kacprow21324/STM32F3Discovery-Autonomiczny-Pojazd/README.md

# 🚗 Autonomiczny Pojazd z STM32

Projekt semestralny z przedmiotu **Systemy Wbudowane i Mikrokontrolery**  
Autor: Kacper Adam Woszczyło  
Numer indeksu: 21324  
Data rozpoczęcia: 28.04.2025   
Repozytorium zawiera kod, dokumentację oraz materiały projektowe.

---

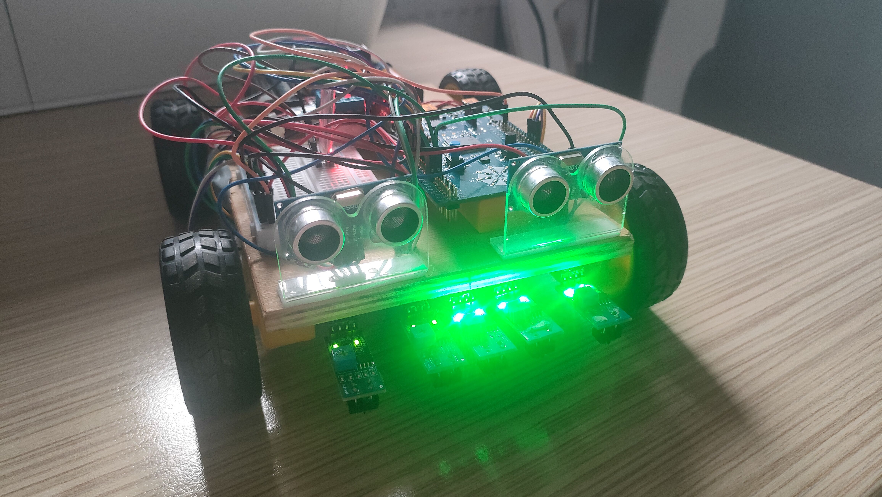
[picture p1: Media/Zdjęcia/M3_3.jpg]
M3_3


---

## 📌 Opis projektu

Projekt zakłada stworzenie zaawansowanego modelu pojazdu autonomicznego opartego na mikrokontrolerze STM32F3Discovery, który może funkcjonować w dwóch trybach działania: półautomatycznym oraz w pełni autonomicznym. W trybie półautomatycznym pojazd realizuje komendy wydawane przez użytkownika za pośrednictwem interfejsu UART, który umożliwia komunikację np. za pomocą modułu Bluetooth HC-05. W trybie automatycznym pojazd samodzielnie analizuje otoczenie przy użyciu zestawu sensorów ultradźwiękowych (HC-SR04) oraz optycznych (czujniki IR TCRT5000), co pozwala mu wykrywać i zatrzymać się jeżeli wykryje daną przeszkode oraz precyzyjnie podążać za namalowaną na podłożu linią trasy. Sterowanie napędem jest realizowane za pomocą sygnałów PWM generowanych przez wbudowane timery mikrokontrolera, umożliwiających precyzyjną regulację prędkości jazdy oraz płynność manewrów. System sterowania opiera się na efektywnej obsłudze przerwań oraz ewentualnie na systemie operacyjnym czasu rzeczywistego (RTOS), zapewniającym dokładne zarządzanie zadaniami. Użytkownik poprzez komendy UART może dynamicznie zmieniać parametry jazdy, odczytywać aktualny stan czujników oraz przełączać tryby pracy pojazdu, co umożliwia pełną kontrolę oraz analizę danych w czasie rzeczywistym.

---

## 🛠️ Zastosowane technologie i narzędzia

- **Mikrokontroler:** STM32F3DISCOVERY
- **IDE:** STM32CubeIDE
- **Programowanie:** C (HAL / LL)
- **Sensory:**
  - 2x HC-SR04 (ultradźwiękowy)
  - 5x Sensory optyczne TCRT5000 (IR)
- **Zasilanie:** Koszyk na 6 baterii typu AA (R6) - 1x6
- **Sterownik silników:** L298N
- **Komunikacja:** UART przez Bluetooth HC-05
- **Sterowanie:** Aplikacja mobilna [`Serial Bluetooth Terminal`](https://play.google.com/store/apps/details?id=de.kai_morich.serial_bluetooth_terminal&hl=pl) (Android)

---

## 🛠️ Schemat podłączeń

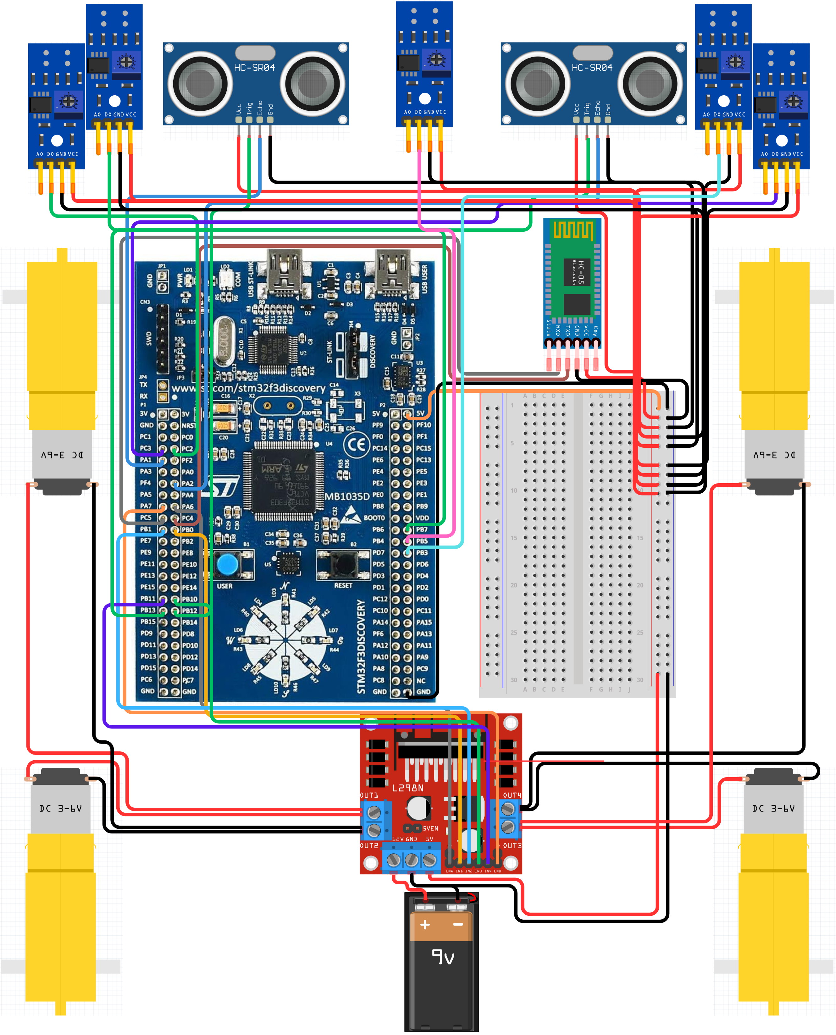
[picture p2: Dokumentacja/Schemat4.2.png]
S2


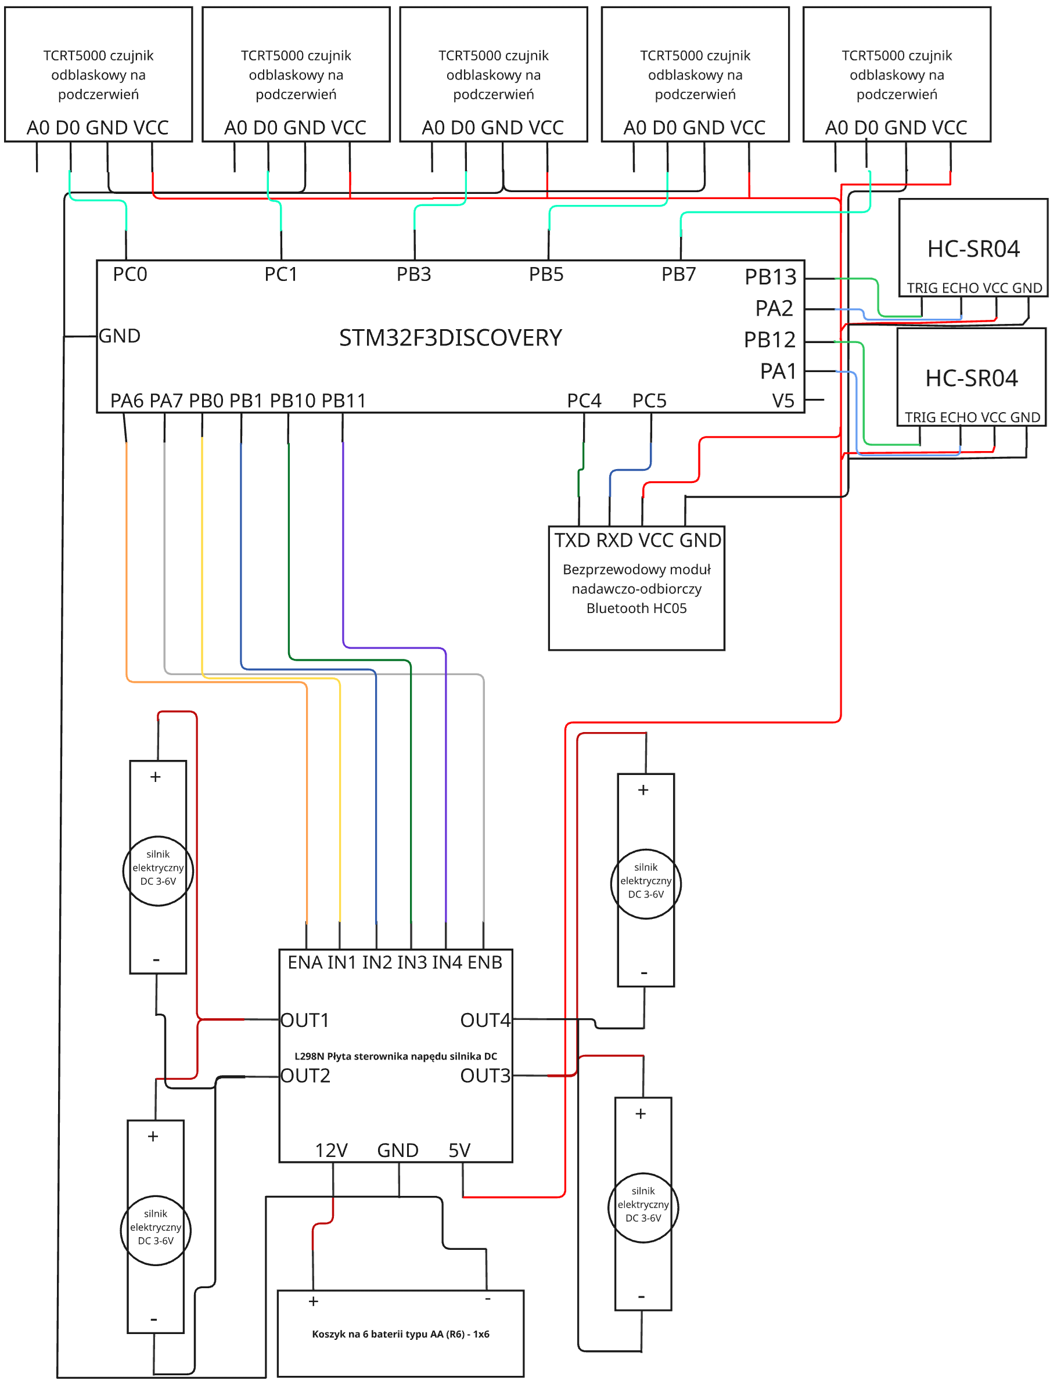
[picture p3: Dokumentacja/Schemat4.1.png]
S1


---

## 🔩 Opis połączeń

1. **Silnik 1 (lewy górny):**  
   - L298N → `OUT1` (czerwony), `OUT2` (czarny)

2. **Silnik 2 (lewy dolny):**  
   - L298N → `OUT1` (czerwony), `OUT2` (czarny)

3. **Silnik 3 (prawy górny):**  
   - L298N → `OUT3` (czerwony), `OUT4` (czarny)

4. **Silnik 4 (prawy dolny):**  
   - L298N → `OUT3` (czerwony), `OUT4` (czarny)

5. **L298N – sterowanie kanałem A (silniki 1 + 2):**  
   - `ENA` → `PB10` (STM32F3, PWM)  
   - `IN1` → `PA6` (STM32F3)  
   - `IN2` → `PA7` (STM32F3)

6. **L298N – sterowanie kanałem B (silniki 3 + 4):**  
   - `ENB` → `PB11` (STM32F3, PWM)  
   - `IN3` → `PB0` (STM32F3)  
   - `IN4` → `PB1` (STM32F3)

7. **Czujnik TCRT5000 #1:**  
   - `A0` → `PC0`  
   - `GND` → `GND`  
   - `VCC` → `V5`

8. **Czujnik TCRT5000 #2:**  
   - `A0` → `PC1`  
   - `GND` → `GND`  
   - `VCC` → `V5`

9. **Czujnik TCRT5000 #3:**  
   - `A0` → `PB3`  
   - `GND` → `GND`  
   - `VCC` → `V5`

10. **Czujnik TCRT5000 #4:**  
    - `A0` → `PB5`  
    - `GND` → `GND`  
    - `VCC` → `V5`

11. **Czujnik TCRT5000 #5:**  
    - `A0` → `PB7`  
    - `GND` → `GND`  
    - `VCC` → `V5`

12. **HC-SR04 #1 (lewy):**  
    - `TRIG` → `PB13`  
    - `ECHO` → `PA2`  
    - `VCC` → `V5`  
    - `GND` → `GND`

13. **HC-SR04 #2 (prawy):**  
    - `TRIG` → `PB12`  
    - `ECHO` → `PA1`  
    - `VCC` → `V5`  
    - `GND` → `GND`

14. **HC-05 (Bluetooth):**  
    - `TXD` → `PC4`  
    - `RXD` ← `PC5`  
    - `VCC` → `V5`  
    - `GND` → `GND`

15. **Zasilanie 12 V:**  
    - Bateria 6×AA → `L298N 12 V IN`

16. **Regulator 5 V (L298N):**  
    - `L298N 5 V` → `V5 (STM32F3)` → zasila moduły 5 V

17. **Masa (GND):**  
    - `Bateria GND` → `L298N GND` → wspólna `GND` →  
      - `STM32F3 GND`  
      - GND TCRT5000 (#1–#5)  
      - GND HC-SR04 (#1–#2)  
      - GND HC-05

---

## 📒 Instrukcja uruchomienia

1. Pobieramy program [`STM32CubeIDE`](https://www.st.com/en/development-tools/stm32cubeide.html#get-software) - najlepiej najnowszą wersję.

obraz

2. Pobierz repozytorium w następujących krokach:

```

1. Otwórz terminal (Git Bash, Terminal macOS/Linux lub PowerShell).  
2. Przejdź do folderu, w którym chcesz umieścić projekt. Przykład:
   
   cd ~/MojeProjekty

3. Skopiuj repozytorium lokalnie poleceniem:

   git clone https://github.com/kacprow21324/STM32F3Discovery-Autonomiczny-Pojazd.git

4. Wejdź do katalogu projektu:

   cd STM32F3Discovery-Autonomiczny-Pojazd

5. Aby w przyszłości pobrać aktualizacje z GitHub:

   git pull

```

3. W programie STM32CubeIDE przechodzimy do zakładki File, a następnie klikamy przycisk "Import".

obraz

4. W oknie "Import" należy rozwinąć zakładke "General", a później zaznaczyć opcję "Exitsting Projects into Workspace", a następnie kliknąć "Next".

obraz

5. Poźniej za pomocą przycisku "Browse" wybieramy ścieżke, w której znajduje się nasz projekt i klikamy przycisk "Finish".

obraz

6. Następnie przechodzimy do "Core", które rozwijamy, dalej rozwijamy, zakładke "Src", tam przechodzimy do pliku "main.c", w którym znajduje się główny kod projektu.

obraz

7. Na końcu wgrywamy program za pomocą opcji "Run" oraz czekamy aż program załaduje się na płytkę.

obraz

---

## ⚙️ Funkcjonalności

- ✅ **Napęd robota sterowany przez PWM** – płynna kontrola prędkości silników
- ✅ **Jazda do przodu, do tyłu, skręt w lewo i prawo** – niezależne sterowanie silnikami przez mostek
- ✅ **Regulacja prędkości jazdy** – możliwość zwiększania i zmniejszania prędkości
- ✅ **Jazda po linii z detekcją przeszkód** – reagowanie przez sensorów IR i czujniki ultradźwiękowe
- ✅ **Unikanie kolizji** – zatrzymywanie robota w przypadku wykrycia przeszkody
- ✅ **Zdalne sterowanie przez Bluetooth (HC-05)** z poziomu np. telefonu
- ✅ **Sterowanie tekstowe przez UART** – wysyłanie komend do robota
- ✅ **Wyświetlanie odległości** – robot przesyła informacje o odległości z lewej i prawej strony
- ✅ **Tryb automatyczny (jazda po linii)** – robot samodzielnie podąża za trasą i omija przeszkody
- ✅ **Autonomiczne zasilanie bateryjne** – pełna autonomia

---

## 📁 Struktura repozytorium

```

STM32F3Discovery-Autonomiczny-Pojazd/
├───Dokumentacja
├───Kod
│   ├───.settings
│   ├───Core
│   │   ├───Inc
│   │   ├───Src
│   │   └───Startup
│   ├───Debug
│   │   ├───Core
│   │   │   ├───Src
│   │   │   └───Startup
│   │   └───Drivers
│   │       └───STM32F3xx_HAL_Driver
│   │           └───Src
│   └───Drivers
│       ├───CMSIS
│       │   ├───Device
│       │   │   └───ST
│       │   │       └───STM32F3xx
│       │   │           ├───Include
│       │   │           └───Source
│       │   │               └───Templates
│       │   └───Include
│       └───STM32F3xx_HAL_Driver
│           ├───Inc
│           │   └───Legacy
│           └───Src
└───Media
    ├───Filmy
    └───Zdjęcia

```
---

## 📡 Komendy UART

| Komenda | Opis |
|---:|---|
| `G` | Jazda do przodu |
| `T` | Jazda do tyłu |
| `L` | Skręt w lewo |
| `P` | Skręt w prawo |
| `S` | Zatrzymanie robota |
| `M` | Zwiększenie prędkości |
| `N` | Zmniejszenie prędkości |
| `A` | Włączenie trybu automatycznego (jazda po linii) |
| `a` | Wyłączenie trybu automatycznego i zatrzymanie |
| `O` | Wyświetlenie odległości z czujników |

---

## 🧪 Scenariusze testowe

- ✔ Detekcja przeszkody z przodu (sensor HC-SR04)
- ✔ Reakcja na białą/czarną linię (czujniki IR)
- ✔ Komunikacja przez Bluetooth z aplikacją mobilną
- ✔ Test zasilania bateryjnego (mobilność bez kabli)
- ✔ Sterowanie ruchem w czasie rzeczywistym (UART)
- ✔ Zmiana prędkości robota komendami
- ✔ Przełączanie między trybem ręcznym a automatycznym
- ✔ Poprawne zatrzymanie robota na komendę
- ✔ Odczyt i transmisja odległości przez UART
- ✔ Reakcja na przeszkody podczas jazdy po linii

---

## 📸 Demo i zdjęcia

- [`Zdjęcia pojazdu`](./Media/Zdjęcia)
- [`Nagranie testów`](./Media/Filmy)

---

## 📄 Dokumentacja

Pełna dokumentacja projektu znajduje się w folderze [`Dokumentacja`](./Dokumentacja/), w tym:
- Raporty z postępów prac nad pojazdem
- Schematy układów
- Lista komponentów

---

## 📅 Harmonogram pracy

- Milestone 1: 19.05.2025
- Milestone 2: 27.05.2025
- Milestone 3: 03.06.2025
- Prezentacja projektu: 10.06.2025

---

## 🧠 Wnioski

1. **Skuteczna regulacja prędkości i stabilność jazdy**  
   Dzięki zastosowaniu modułu PWM na timerze TIM3 oraz funkcji `aktualizujPredkosc` udało się uzyskać płynną i powtarzalną kontrolę prędkości w zakresie od 0 do 100 %. Precyzyjne ustawienie wypełnienia sygnału PWM przełożyło się na stabilne zachowanie robota przy różnych prędkościach, co potwierdziły testy porównawcze w warunkach laboratoryjnych.

2. **Niezawodne sterowanie kierunkiem ruchu**  
   Implementacja funkcji sterujących (m.in. `jedzNaprzod`, `jedzDoTylu`, `skrecWLewo`, `skrecWPrawo`, `zatrzymajRobota`) pozwoliła na szybkie i jednoznaczne określenie stanu pinów IN1–IN4, co przełożyło się na natychmiastowe reakcje silników. W trakcie testów robot reagował bez opóźnień na komendy zmiany kierunku, co świadczy o poprawnej konfiguracji GPIO oraz logicznej spójności kodu.

3. **Rzetelne pomiary odległości i bezpieczeństwo**  
   Zastosowanie dwóch czujników ultradźwiękowych (funkcja `zmierzOdleglosc`) udało się zintegrować w sposób umożliwiający pomiar odległości z częstotliwością umożliwiającą wykrywanie przeszkód w czasie rzeczywistym. Sprawdzone algorytmy zabezpieczające (timeout w oczekiwaniu na echo) chroniły przed blokowaniem programu w przypadku błędnych sygnałów, co zwiększyło bezpieczeństwo działania robota.

4. **Precyzyjne śledzenie linii z minimalnym zakłóceniem**  
   Algorytm `jedzPoLinii`, oparty na pięciu czujnikach IR, wykazał wysoką skuteczność w utrzymywaniu robota na zadanej trasie. Analiza stanów czujników (skrajnie lewy, lewy, centralny, prawy, skrajnie prawy) w połączeniu z dynamicznym dostosowywaniem kierunku i prędkości zapewniła płynne śledzenie linii nawet przy niewielkich odchyleniach, bez konieczności dodatkowych filtrów czy skomplikowanych wag.

5. **Responsywna komunikacja UART i ergonomia sterowania**  
   Wykorzystanie przerwań UART (`HAL_UART_Receive_IT` oraz `HAL_UART_RxCpltCallback`) umożliwiło asynchroniczne odbieranie komend od użytkownika, co znacznie poprawiło ergonomię obsługi robota. Użytkownik otrzymuje zwrotną informację o stanie (np. aktualnej prędkości) szybko i bez opóźnień, co potwierdziły próby ręcznego sterowania. Ten model komunikacji minimalizuje ryzyko opóźnień i kolizji w głównej pętli sterującej.  

---

## 📬 Kontakt

W razie pytań:
- Email:   21324@student.ans-elblag.pl
- GitHub:  https://github.com/kacprow21324

---

**Licencja:** [`MIT`](./LICENSE.md)
