kacprow21324/STM32F3Discovery-Autonomiczny-Pojazd/Dokumentacja/Schemat4.1.pdf

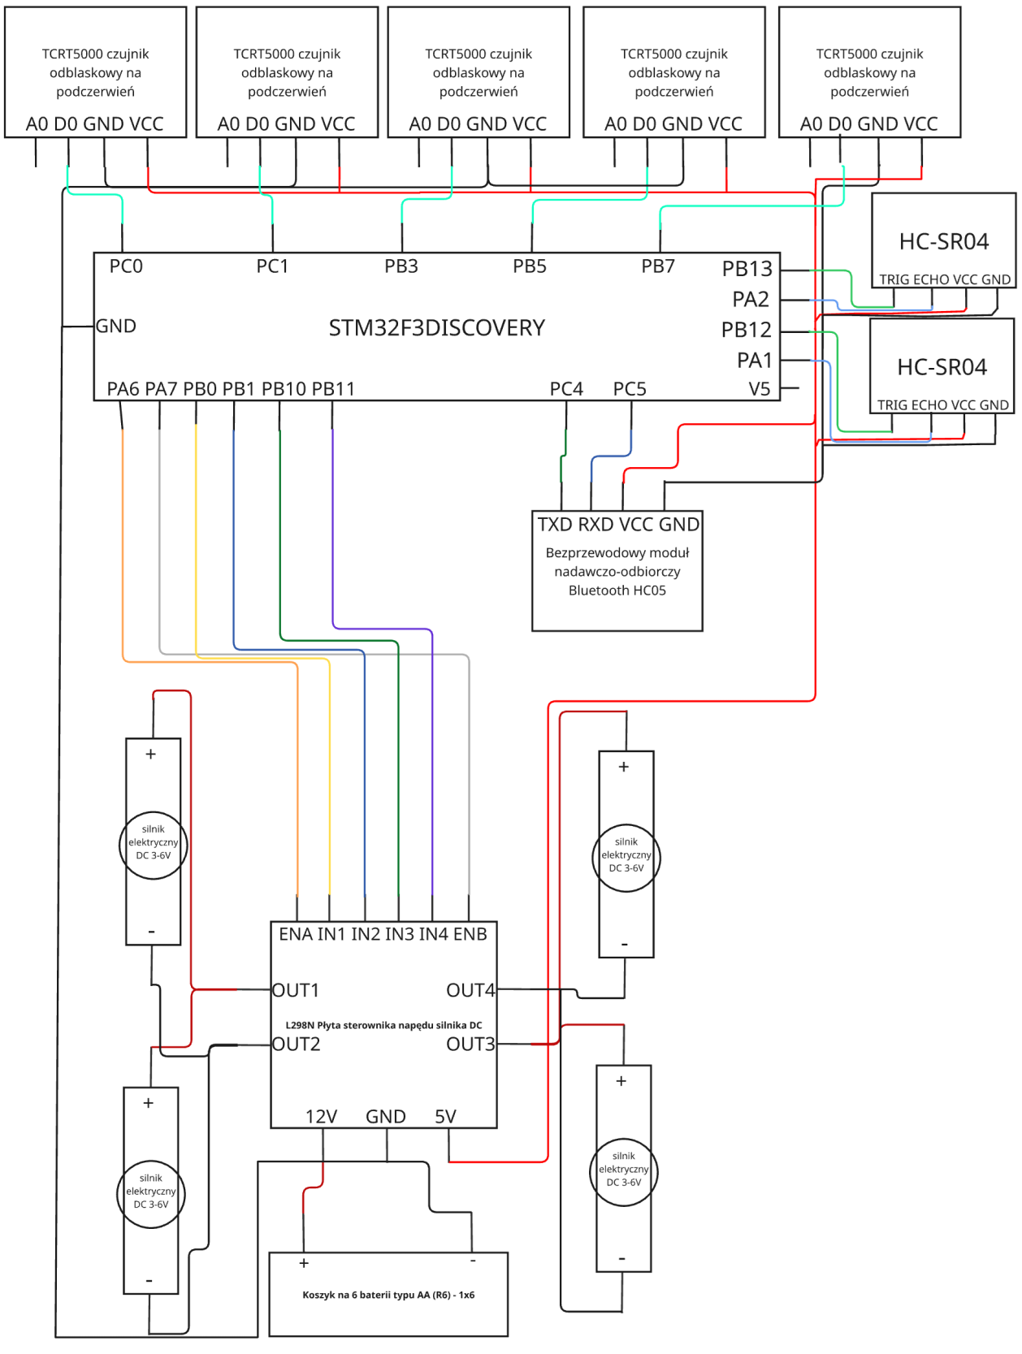
[picture p42: figure]
