kacprow21324/STM32F3Discovery-Autonomiczny-Pojazd/Dokumentacja/Schemat4.2.pdf

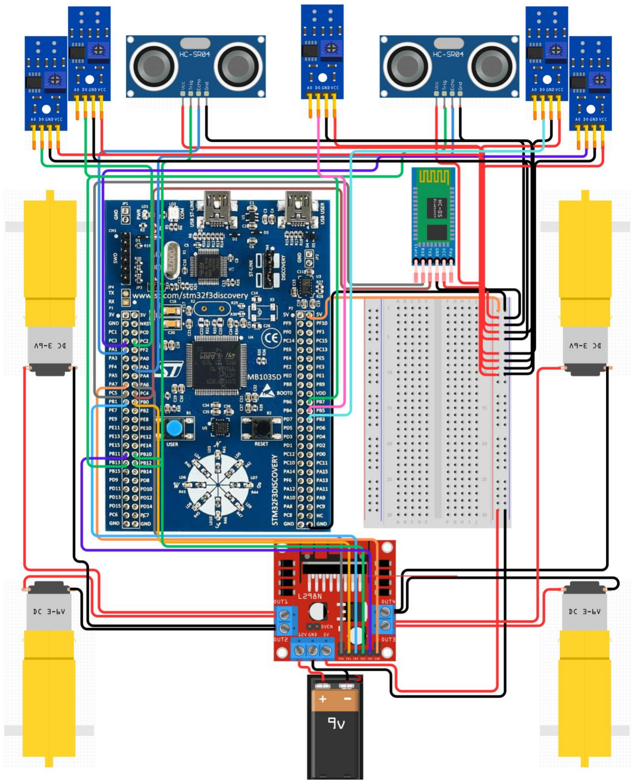
[picture p43: figure]
