kacprow21324/STM32F3Discovery-Autonomiczny-Pojazd/Media/Zdjęcia/M1_3.jpg

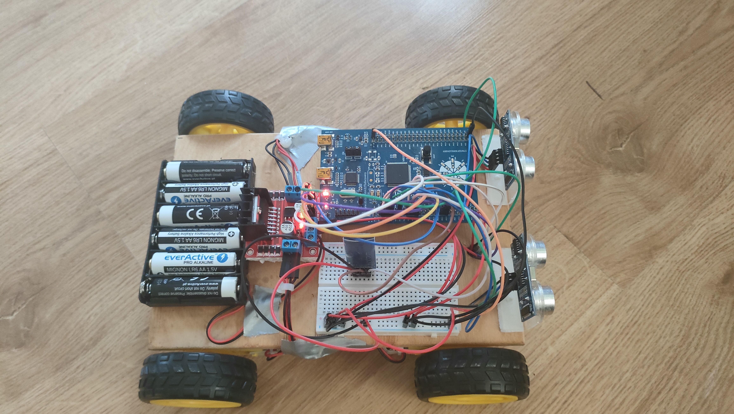
Media/Zdjęcia/M1_3.jpg
