kacprow21324/STM32F3Discovery-Autonomiczny-Pojazd/Media/Zdjęcia/M2_1.jpg

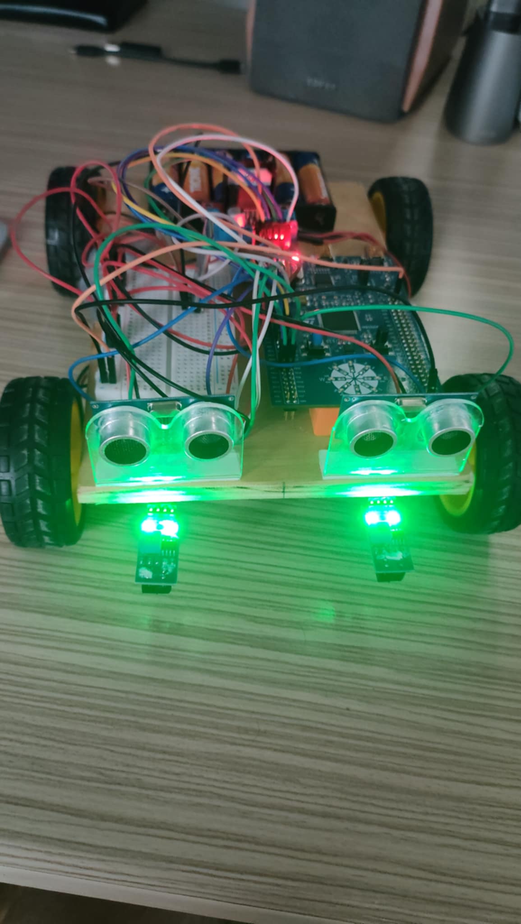
Media/Zdjęcia/M2_1.jpg
