kacprow21324/STM32F3Discovery-Autonomiczny-Pojazd/Media/Zdjęcia/M3_1.jpg

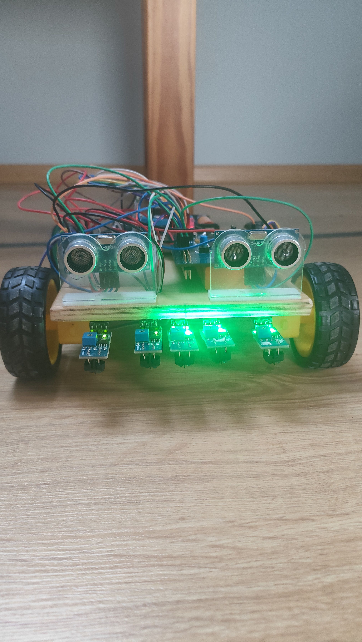
Media/Zdjęcia/M3_1.jpg
