kacprow21324/STM32F3Discovery-Autonomiczny-Pojazd/Media/Zdjęcia/tor_jazdy.jpg

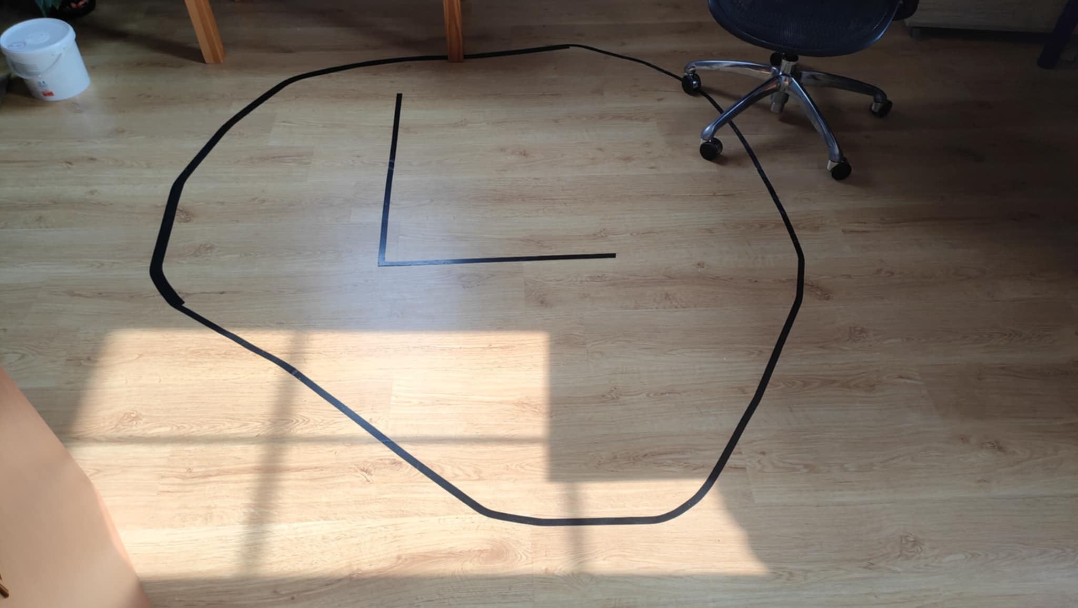
Media/Zdjęcia/tor_jazdy.jpg
