kacprow21324/STM32F3Discovery-Autonomiczny-Pojazd/Kod/Core/Src/main.c

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
/* Includes ------------------------------------------------------------------*/
#include "main.h"

/* USER CODE BEGIN Includes */
#include <string.h>
#include <stdio.h>
/* USER CODE END Includes */

/* USER CODE BEGIN PD */
#define PREDKOSC_MIN     0
#define PREDKOSC_MAX   100
#define KROK_PREDKOSCI   10
/* USER CODE END PD */

TIM_HandleTypeDef htim2;
TIM_HandleTypeDef htim3;

UART_HandleTypeDef huart1;

/* USER CODE BEGIN PV */
volatile uint8_t Auto = 0;
volatile uint8_t procentPredkosci = 10;
char znak;
int ostatniKierunek = 0;
uint32_t lewaOdleglosc = 0;
uint32_t prawaOdleglosc = 0;
volatile uint8_t pokazOdleglosc = 0;
/* USER CODE END PV */

void SystemClock_Config(void);
static void MX_GPIO_Init(void);
static void MX_TIM3_Init(void);
static void MX_TIM2_Init(void);
static void MX_USART1_UART_Init(void);
/* USER CODE BEGIN PFP */
void aktualizujPredkosc(void);
void zatrzymajSilniki(void);
void jedzNaprzod(void);
void jedzDoTylu(void);
void skrecWLewo(void);
void skrecWPrawo(void);
void zatrzymajRobota(void);
void jedzPoLinii(void);
void obslugaMenu(char znak);
uint32_t zmierzOdleglosc(GPIO_TypeDef* trigPort, uint16_t trigPin, GPIO_TypeDef* echoPort, uint16_t echoPin);
void wyswietlOdleglosc(void);

/* USER CODE END PFP */

/* USER CODE BEGIN 0 */

/*=============================================================================
  Ustawianie PWM wg procentuPredkosci
=============================================================================*/
void aktualizujPredkosc(void)
{
   uint32_t period = htim3.Init.Period + 1;
   uint32_t predkosc = (period * procentPredkosci) / 100;
   __HAL_TIM_SET_COMPARE(&htim3, TIM_CHANNEL_1, predkosc);
   __HAL_TIM_SET_COMPARE(&htim3, TIM_CHANNEL_2, predkosc);
}

/*=============================================================================
  Zatrzymanie silników
=============================================================================*/
void zatrzymajSilniki(void)
{
   __HAL_TIM_SET_COMPARE(&htim3, TIM_CHANNEL_1, 0);
   __HAL_TIM_SET_COMPARE(&htim3, TIM_CHANNEL_2, 0);
}

/*=============================================================================
  Jazda do przodu – oba silniki do przodu
=============================================================================*/
void jedzNaprzod(void)
{
   HAL_GPIO_WritePin(IN1_GPIO_Port, IN1_Pin, GPIO_PIN_SET);
   HAL_GPIO_WritePin(IN2_GPIO_Port, IN2_Pin, GPIO_PIN_RESET);
   HAL_GPIO_WritePin(IN3_GPIO_Port, IN3_Pin, GPIO_PIN_SET);
   HAL_GPIO_WritePin(IN4_GPIO_Port, IN4_Pin, GPIO_PIN_RESET);
   aktualizujPredkosc();
}

/*=============================================================================
  Jazda do tyłu – oba silniki do tyłu
=============================================================================*/
void jedzDoTylu(void)
{
   HAL_GPIO_WritePin(IN1_GPIO_Port, IN1_Pin, GPIO_PIN_RESET);
   HAL_GPIO_WritePin(IN2_GPIO_Port, IN2_Pin, GPIO_PIN_SET);
   HAL_GPIO_WritePin(IN3_GPIO_Port, IN3_Pin, GPIO_PIN_RESET);
   HAL_GPIO_WritePin(IN4_GPIO_Port, IN4_Pin, GPIO_PIN_SET);
   aktualizujPredkosc();
}

/*=============================================================================
  Skręt w lewo: lewy silnik do tyłu, prawy do przodu
=============================================================================*/
void skrecWLewo(void)
{
   HAL_GPIO_WritePin(IN1_GPIO_Port, IN1_Pin, GPIO_PIN_SET);
   HAL_GPIO_WritePin(IN2_GPIO_Port, IN2_Pin, GPIO_PIN_RESET);
   HAL_GPIO_WritePin(IN3_GPIO_Port, IN3_Pin, GPIO_PIN_RESET);
   HAL_GPIO_WritePin(IN4_GPIO_Port, IN4_Pin, GPIO_PIN_SET);
   aktualizujPredkosc();
}

/*=============================================================================
  Skręt w prawo: lewy silnik do przodu, prawy do tyłu
=============================================================================*/
void skrecWPrawo(void)
{
   HAL_GPIO_WritePin(IN1_GPIO_Port, IN1_Pin, GPIO_PIN_RESET);
   HAL_GPIO_WritePin(IN2_GPIO_Port, IN2_Pin, GPIO_PIN_SET);
   HAL_GPIO_WritePin(IN3_GPIO_Port, IN3_Pin, GPIO_PIN_SET);
   HAL_GPIO_WritePin(IN4_GPIO_Port, IN4_Pin, GPIO_PIN_RESET);
   aktualizujPredkosc();
}

/*=============================================================================
  Pełne zatrzymanie robota
=============================================================================*/
void zatrzymajRobota(void)
{
   zatrzymajSilniki();
   HAL_GPIO_WritePin(IN1_GPIO_Port, IN1_Pin, GPIO_PIN_RESET);
   HAL_GPIO_WritePin(IN2_GPIO_Port, IN2_Pin, GPIO_PIN_RESET);
   HAL_GPIO_WritePin(IN3_GPIO_Port, IN3_Pin, GPIO_PIN_RESET);
   HAL_GPIO_WritePin(IN4_GPIO_Port, IN4_Pin, GPIO_PIN_RESET);
}

/*=============================================================================
  Pomiar odległości za pomocą czujnikow ultradźwiękowych
=============================================================================*/
uint32_t zmierzOdleglosc(GPIO_TypeDef* trigPort, uint16_t trigPin, GPIO_TypeDef* echoPort, uint16_t echoPin)
{
	uint32_t start = 0, stop = 0;
	uint32_t timeout = HAL_GetTick();

	HAL_GPIO_WritePin(trigPort, trigPin, 0);
	HAL_Delay(1);
	HAL_GPIO_WritePin(trigPort, trigPin, 1);
	__HAL_TIM_SET_COUNTER(&htim2, 0);

	while (__HAL_TIM_GET_COUNTER(&htim2) < 10);
	HAL_GPIO_WritePin(trigPort, trigPin, 0);

	while (HAL_GPIO_ReadPin(echoPort, echoPin) == 0)
	{
		if (HAL_GetTick() - timeout > 10) return 0;
	}
	start = __HAL_TIM_GET_COUNTER(&htim2);

	timeout = HAL_GetTick();
	while (HAL_GPIO_ReadPin(echoPort, echoPin) == 1)
	{
		if (HAL_GetTick() - timeout > 50) return 0;
	}
	stop = __HAL_TIM_GET_COUNTER(&htim2);

	uint32_t czas = (stop > start) ? (stop - start) : 0;

	return (uint32_t)(czas * 0.017f);
}

/*=============================================================================
  Jazda po linii z reakcją na czujniki IR oraz czujniki odległości
=============================================================================*/
void jedzPoLinii(void)
{
	lewaOdleglosc  = zmierzOdleglosc(GPIOB, TRIG1_Pin, GPIOA, GPIO_PIN_1);
	prawaOdleglosc = zmierzOdleglosc(GPIOB, TRIG2_Pin, GPIOA, GPIO_PIN_2);

	if (lewaOdleglosc < 15 || prawaOdleglosc < 15)
	{
		zatrzymajRobota();
		return;
	}

    aktualizujPredkosc();

    uint8_t skrajnieLewySensor  = HAL_GPIO_ReadPin(IR_LEFTMOST_D0_GPIO_Port, IR_LEFTMOST_D0_Pin);
    uint8_t lewySensor          = HAL_GPIO_ReadPin(IR_LEFT_D0_GPIO_Port,     IR_LEFT_D0_Pin);
    uint8_t centralnySensor     = HAL_GPIO_ReadPin(IR_CENTER_D0_GPIO_Port,   IR_CENTER_D0_Pin);
    uint8_t prawySensor         = HAL_GPIO_ReadPin(IR_RIGHT_D0_GPIO_Port,    IR_RIGHT_D0_Pin);
    uint8_t skrajniePrawySensor = HAL_GPIO_ReadPin(IR_RIGHTMOST_D0_GPIO_Port, IR_RIGHTMOST_D0_Pin);

    if (centralnySensor == 1)
    {
        jedzNaprzod();
        ostatniKierunek = 0;
    }
    else if (lewySensor == 1)
    {
        skrecWLewo();
        ostatniKierunek = 1;
    }
    else if (prawySensor == 1)
    {
        skrecWPrawo();
        ostatniKierunek = 2;
    }
    else if (skrajnieLewySensor == 1)
    {
        skrecWLewo();
        ostatniKierunek = 1;
    }
    else if (skrajniePrawySensor == 1)
    {
        skrecWPrawo();
        ostatniKierunek = 2;
    }
    else
    {
        jedzDoTylu();
        HAL_Delay(30);

        if (ostatniKierunek == 1)
        {
            skrecWLewo();
        }
        else if (ostatniKierunek == 2)
        {
            skrecWPrawo();
        }
        else
        {
            jedzNaprzod();
        }

        HAL_Delay(150);
        zatrzymajSilniki();
    }
}

/*=============================================================================
  Wyświetlanie odległości zmierzonych przez oba czujniki
=============================================================================*/
void wyswietlOdleglosc(void)
{
	lewaOdleglosc = zmierzOdleglosc(GPIOB, TRIG1_Pin, GPIOA, GPIO_PIN_1);
	prawaOdleglosc = zmierzOdleglosc(GPIOB, TRIG2_Pin, GPIOA, GPIO_PIN_2);
	char tekst[64];
	sprintf(tekst, "Lewy: %lu cm | Prawy: %lu cm\r\n", lewaOdleglosc, prawaOdleglosc);
	HAL_UART_Transmit(&huart1, (uint8_t*)tekst, strlen(tekst), HAL_MAX_DELAY);
}

/*=============================================================================
  MENU (UART)
=============================================================================*/
void obslugaMenu(char znak)
{
   switch (znak)
   {
   case 'M':
      if (procentPredkosci + KROK_PREDKOSCI <= PREDKOSC_MAX) {
         procentPredkosci += KROK_PREDKOSCI;
      } else {
         procentPredkosci = PREDKOSC_MAX;
      }
      aktualizujPredkosc();
      break;

   case 'N':
      if (procentPredkosci >= KROK_PREDKOSCI) {
         procentPredkosci -= KROK_PREDKOSCI;
      } else {
         procentPredkosci = PREDKOSC_MIN;
      }
      aktualizujPredkosc();
      break;

   case 'G':
      jedzNaprzod();
      break;

   case 'T':
      jedzDoTylu();
      break;

   case 'L':
      skrecWLewo();
      break;

   case 'P':
      skrecWPrawo();
      break;
   case 'S':
      zatrzymajRobota();
      break;
   case 'A':
      Auto = 1;
      break;
   case 'a':
      Auto = 0;
      zatrzymajRobota();
      break;
   case 'O':
	  pokazOdleglosc = 1;
      break;
   default:
      break;
   }
}
/* USER CODE END 0 */

/**
  * @brief  The application entry point.
  * @retval int
  */
int main(void)
{

  /* MCU Configuration--------------------------------------------------------*/

  /* Reset of all peripherals, Initializes the Flash interface and the Systick. */
  HAL_Init();

  /* Configure the system clock */
  SystemClock_Config();

  /* Initialize all configured peripherals */
  MX_GPIO_Init();
  MX_TIM3_Init();
  MX_TIM2_Init();
  MX_USART1_UART_Init();
  /* USER CODE BEGIN 2 */
  HAL_TIM_PWM_Start(&htim3, TIM_CHANNEL_1);
  HAL_TIM_PWM_Start(&htim3, TIM_CHANNEL_2);

  aktualizujPredkosc();

  HAL_TIM_Base_Start(&htim2);
  HAL_UART_Receive_IT(&huart1, (uint8_t*)&znak, 1);

  char *w = "Robot Działa\r\n";
  HAL_UART_Transmit(&huart1, (uint8_t*)w, strlen(w), HAL_MAX_DELAY);
  /* USER CODE END 2 */

  /* Infinite loop */
  /* USER CODE BEGIN WHILE */
  while (1)
  {
     if (Auto==1)
     {
    	 jedzPoLinii();
     }
     if (pokazOdleglosc==1)
     {
         wyswietlOdleglosc();
         pokazOdleglosc=0;
     }
  }
    /* USER CODE END WHILE */

}

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
/* USER CODE BEGIN 4 */
void HAL_UART_RxCpltCallback(UART_HandleTypeDef *huart)
{
   if (huart->Instance == USART1)
   {
      obslugaMenu(znak);
      HAL_UART_Receive_IT(&huart1, (uint8_t*)&znak, 1);
   }
}
/* USER CODE END 4 */
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
