kacprow21324/STM32F3Discovery-Autonomiczny-Pojazd/Kod/Core/Inc/main.h

#define IR_RIGHTMOST_D0_Pin GPIO_PIN_2
#define IR_RIGHTMOST_D0_GPIO_Port GPIOC
#define IR_LEFTMOST_D0_Pin GPIO_PIN_3
#define IR_LEFTMOST_D0_GPIO_Port GPIOC
#define ECHO1_Pin GPIO_PIN_1
#define ECHO1_GPIO_Port GPIOA
#define ECHO2_Pin GPIO_PIN_2
#define ECHO2_GPIO_Port GPIOA
#define ENA_Pin GPIO_PIN_6
#define ENA_GPIO_Port GPIOA
#define ENB_Pin GPIO_PIN_7
#define ENB_GPIO_Port GPIOA
#define IN1_Pin GPIO_PIN_0
#define IN1_GPIO_Port GPIOB
#define IN2_Pin GPIO_PIN_1
#define IN2_GPIO_Port GPIOB
#define IN3_Pin GPIO_PIN_10
#define IN3_GPIO_Port GPIOB
#define IN4_Pin GPIO_PIN_11
#define IN4_GPIO_Port GPIOB
#define TRIG1_Pin GPIO_PIN_12
#define TRIG1_GPIO_Port GPIOB
#define TRIG2_Pin GPIO_PIN_13
#define TRIG2_GPIO_Port GPIOB
#define IR_LEFT_D0_Pin GPIO_PIN_3
#define IR_LEFT_D0_GPIO_Port GPIOB
#define IR_CENTER_D0_Pin GPIO_PIN_5
#define IR_CENTER_D0_GPIO_Port GPIOB
#define IR_RIGHT_D0_Pin GPIO_PIN_7
#define IR_RIGHT_D0_GPIO_Port GPIOB
