kacprow21324/STM32F3Discovery-Autonomiczny-Pojazd/(notices)

Notices in the files:
Kod/Core/Src/main.c:
Copyright (c) 2025 STMicroelectronics.
All rights reserved.
This software is licensed under terms that can be found in the LICENSE file
